AAst7/Quadcopter-FlightController/Controller/Core/Src/main.c

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
/* Includes ------------------------------------------------------------------*/
#include "main.h"
#include "adc.h"
#include "dma.h"
#include "tim.h"
#include "gpio.h"
#include "Variable.h"
#include "Delay.h"
#include "OLED.h"
#include "Data_proc.h"
#include "LED.h"
#include "NRF24L01.h"
#include "Key.h"


void SystemClock_Config(void);
/**
  * @brief  The application entry point.
  * @retval int
  */
int main(void)
{

  /* MCU Configuration--------------------------------------------------------*/

  /* Reset of all peripherals, Initializes the Flash interface and the Systick. */
  HAL_Init();

  /* Configure the system clock */
  SystemClock_Config();

  /* Initialize all configured peripherals */
  MX_GPIO_Init();
  MX_DMA_Init();
  MX_ADC1_Init();
  MX_TIM1_Init();
  MX_TIM3_Init();
  /* USER CODE BEGIN 2 */
  HAL_TIM_Base_Start_IT(&htim1);
  HAL_ADCEx_Calibration_Start(&hadc1);                    // 先开启校准ADC 
  HAL_ADC_Start_DMA(&hadc1,(uint32_t *)Rocker_Value,5);   // 再启动DMA转换
  HAL_TIM_Encoder_Start(&htim3,TIM_CHANNEL_ALL);          // 启动编码器 
  
  DWT_Init();
  OLED_Init();
  NRF24L01_Init();           // 第②步: 只加回初始化, 暂不发送, 看是否黑屏
  OLED_Init();
  
  // OLED_Update();
  /* USER CODE END 2 */

  /* Infinite loop */
  /* USER CODE BEGIN WHILE */
  while (1)
  {
    /* USER CODE END WHILE */
    KeyNUM();
    if(LED_Slow_time == 0)    //LED显示
    {
      LED_Control();
      LED_Slow_time = 1;
    }
    if(Proc_Slow_time == 0)    //变量处理
    {
      Data_Proc();
      Proc_Slow_time = 1;
    }
    if(Disp_Slow_time == 0)    //数据显示
    {
      Data_Display();
      Disp_Slow_time = 1;
    }
    if(Send_Slow_time == 0)    //发送消息------------------暂时注释
    {
      Data_Send();           // 第③步: 打开发送, 定位黑屏是否由此引起
      Send_Slow_time = 1;
    }
    /* USER CODE BEGIN 3 */
  }
  /* USER CODE END 3 */
}

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
/* USER CODE BEGIN 4 */
void HAL_TIM_PeriodElapsedCallback(TIM_HandleTypeDef* htim)     //定时器中断回调函数
{
  if(htim->Instance == TIM1)
  {
     if (++Send_Slow_time > 4)  Send_Slow_time = 0;
        if (++Proc_Slow_time  > 10) Proc_Slow_time = 0;
        if (++Disp_Slow_time  > 15) Disp_Slow_time = 0;
        if (++LED_Slow_time   > 30) LED_Slow_time = 0;

        if (++connect_time > 500) { connect_time = 0; connect_value++; if (connect_value > 200) connect_value = 0; }
  }
}
/* USER CODE END 4 */
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
