AAst7/Quadcopter-FlightController/FlightControl/Core/Src/PowerDetection.c

#include "Variable.h"
#include "main.h"
#include "adc.h"

uint16_t Get_ADC(void)
{
    HAL_ADC_Start(&hadc1);                              //启动单次转换
    HAL_ADC_PollForConversion(&hadc1, 10);              //等转换完成(10ms超时,不会死等)
    return (uint16_t)HAL_ADC_GetValue(&hadc1);          //读取转换结果
}



float GetBattery(void)
{
    float temp_battery;
    temp_battery = (3.3*2*Get_ADC() / 4096);
    return temp_battery;
}


void GetCurrent_Power(void)         //获取当前电量,100次的平均值
{
    if(++Battery_num <= 100)
    {
        Battery_temp = GetBattery();
        Battery_total += Battery_temp;
    }
    else
    {
        Battery_average = (Battery_total / 100);
        Battery_total = 0;
        Battery_num = 0;
    }
}
