AAst7/Quadcopter-FlightController/FlightControl/Core/Inc/Data_proc.h

#ifndef __DATA_PROC_H__
#define __DATA_PROC_H__

#include "main.h"


void fly_task(void);
void LED_Detect(void);
void Data_Proc(void);
void Attitude_Data_Proc(void);
void Data_Display(void);
void Date_Receive(void);
void Data_Send(void);
void Connect_Portect_Test(void);


#endif
