AAst7/Quadcopter-FlightController/FlightControl/Core/Inc/PWM.h

#ifndef __PWM_H__
#define __PWM_H__

#include "main.h"

void SET_Compare1(uint16_t Compare1);
void SET_Compare2(uint16_t Compare2);
void SET_Compare3(uint16_t Compare3);
void SET_Compare4(uint16_t Compare4);










#endif
