AAst7/Quadcopter-FlightController/(commit log)

2026-10-07 init: STM32 空心杯四轴飞控与遥控系统（HAL 重构版）
2026-10-07 docs:修改README描述
2026-10-07 docs: 移除标题中的星号
2026-10-07 docs: 添加遥控端原理图
2026-10-07 docs: 添加遥控端 PCB 顶层
2026-10-07 docs: 添加遥控端 PCB 底层
2026-10-07 docs: 添加飞控端原理图
2026-10-07 docs: 添加飞控端 PCB 顶层
2026-10-07 docs: 添加飞控端 PCB 底层
2026-10-13 fix(controller): 修正 nRF24L01 payload 写入命令，打通发送链路
    - Send(): W_REGISTER+W_TX_PAYLOAD 改为 W_TX_PAYLOAD
    W_TX_PAYLOAD(0xA0) 已是完整命令，再加 W_REGISTER 会写入错误寄存器，
    导致数据发不出去
    - Send(): 先拉低 CE 再配置发送模式，避免残留高电平提前触发
    - Send(): 等待 IRQ 增加约 10ms 超时保护，防止对端未就绪时死等
    - 新增链路状态显示：OLED 显示 S:OK(已联通) / S:<状态码>(无应答)
    - Variable.h: 增加 NRF 诊断寄存器变量，便于现场排查
    - Data_proc.c: 引入 NRF24L01_Reg.h 以使用 TX_OK / MAX_TX 宏
2026-10-13 fix(flightctrl): 修正周期任务漏触发、LED 闪烁卡死与电机 PWM 争用
    - main.c: 主循环周期判断由 == 改为 >=，避免计数器越过后永久漏触发
    - main.c: 移除主循环中直接写电机比较值的代码
    该操作与 1ms 中断里的 Motor_Control() 争用同一组 CCR，导致转速乱跳
    - main.c: 增加 HAL_ADCEx_Calibration_Start()，F1 系列不校准 ADC 读数偏差大
    - main.c: 显式调用 DWT_Init()，保证 Delay_us 可用
    - LED.c: 闪烁计数改为 >= 比较，并在闪烁速率变化时重置计数
    原 == 比较在 500ms 切 50ms 时旧计数值已超过新周期，会出现约 65 秒卡死
    - Data_proc.c: 电池检测增加下限判断
    当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
2026-10-13 docs: 更新飞控端原理图与 PCB（修正 R7 网络标签 BVIN）
2026-10-13 docs: 修正 README，补充硬件缺陷规避与调试记录
    - 修正微秒延时一节：如实记录 DWT 在无调试器时 CYCCNT 不自增导致死循环，
    最终改用经校准的空循环
    - 新增「用软件规避已投板 PCBA 的硬件缺陷」一节
    记录 R7 上端网络标签由 BVIN 误写为 VBIN 导致分压电路悬空、
    电池检测失效并连带占用状态灯，以及选择改软件而非重新打板的决策依据
    - 新增「调试过程中定位并修复的其他问题」表格，含 nRF24L01 payload
    命令错误、LED 计数溢出卡死、主循环与中断争用电机 CCR 等
    - 项目状态表与硬件表同步更新（nRF24L01 通信已打通、电池检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
